123swk123/neoLED-frame-grabber/schematic/neoLED_framegrabber_bottom_layer_mirrored.pdf

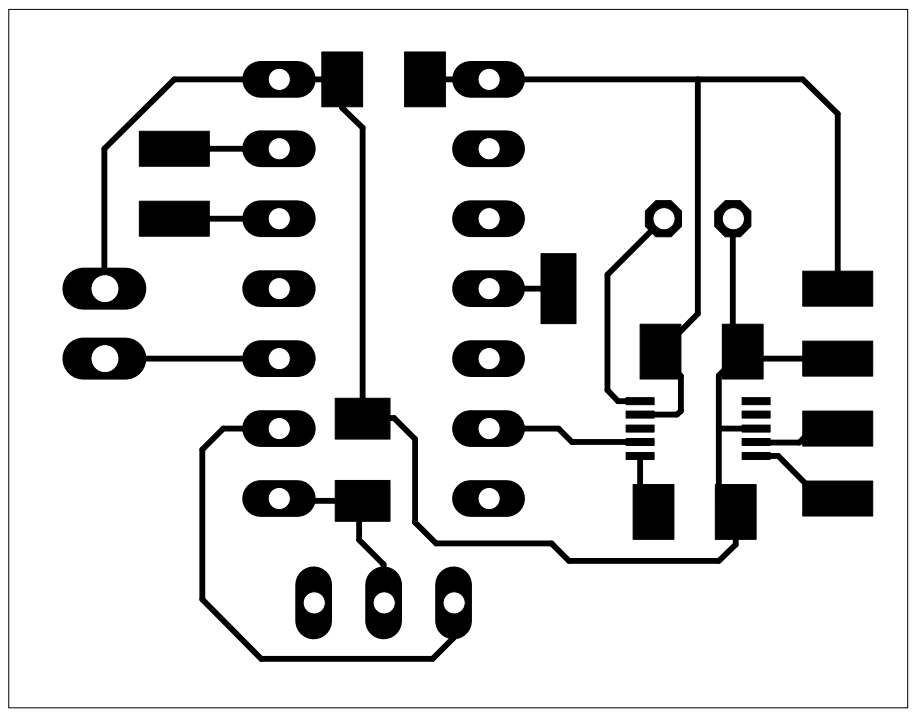
[picture p7: page 1]
