123swk123/neoLED-frame-grabber/schematic/neoLED_framegrabber_schematic.pdf

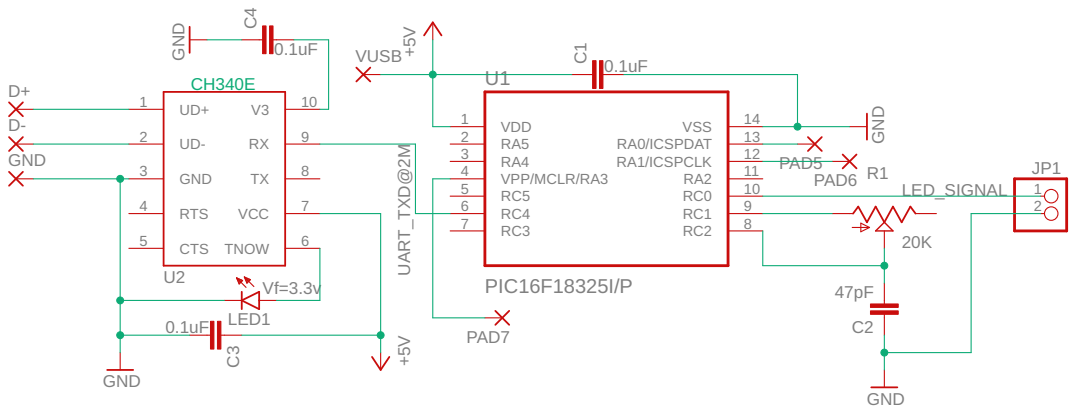
[picture p8: page 1]
