123swk123/neoLED-frame-grabber/schematic/neoLED2SPI.PDF

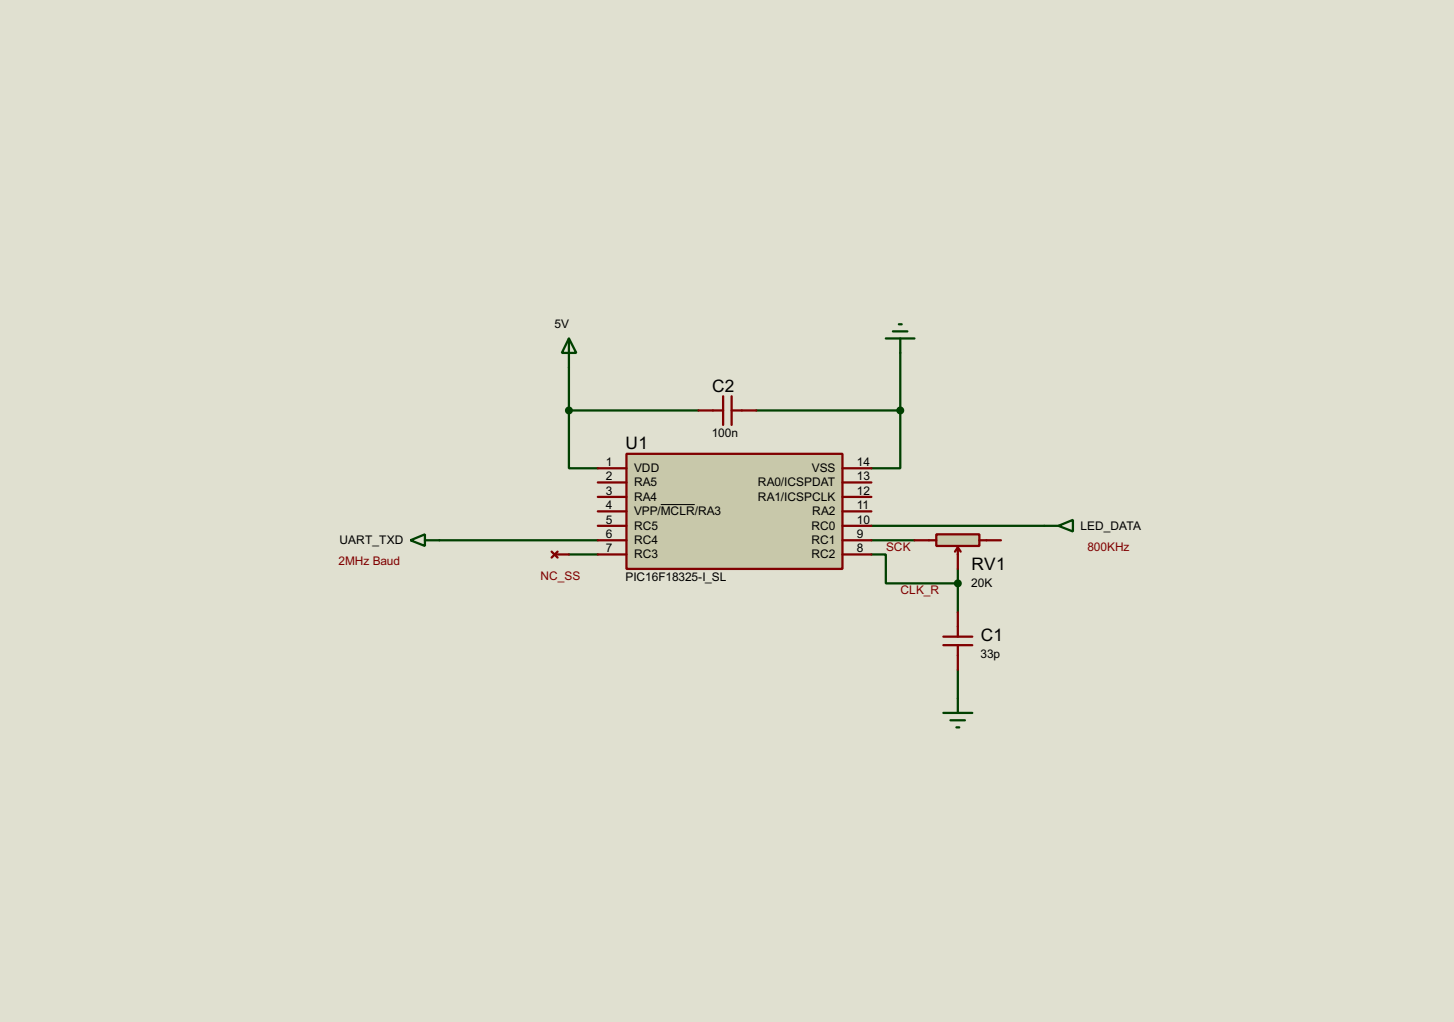
[picture p9: page 1]
