123swk123/neoLED-frame-grabber/(threads)

Thread 1 (2020-07-04):

which platform will require for setup

Kamal-Sonani, 2020-07-04:
i'm using Pycharm, never done with Qt.

check this [image](https://imgur.com/a/hNDin6l)
Where i stuck?
can you please tell me basic steps ?
i sorted all other steps in hardware

Thanks.

123swk123, 2020-07-05:
you need mention some required(must) parameters to run the viewer,
- led type
- led layout arrangement
- panel size (width and height)
- serial port to connect.

for example if you want to frame grab for a led panel(col x row) 16x32 made of ws2811 led and arranged as snake style left to right.

`main.py --led WS2811 --layout SnakeL2R --width 32 --height 16 --port com1`

I have tested it on win10, ubuntu 16.xx/18.xx/20.xx

Kamal-Sonani, 2020-07-11:
i tried & works fine ,UI is opened as per defined matrix size.

i'll check with hardware

Thanks @123swk123

123swk123, 2020-07-20:
cool! @Kamal-Sonani

Closed 2020-07-20.

Thread 2 (2020-10-10):

Not getting any view from input, only layout opened.

Kamal-Sonani, 2020-10-10:
I tried as your documentation , but not getting any animation on matrix.

Is their any other way to verify ?

123swk123, 2020-10-10:
Use --verbose command line option which will show you how the internal buffer is filled and managed, that will give you rough idea where to focus troubleshooting.

123swk123, 2020-10-10:
By the way can you post your command line options?

Kamal-Sonani, 2020-10-10:
https://www.youtube.com/watch?v=QBZyEKiyt6U

just check this video

123swk123, 2020-10-10:
Append --verbose to your command line options

neoLEDViewer.py --led WS2811 --layout SnakeL2R --width 10 --height 10 --port com6 --verbose

Just make sure led panel width and height mention the command line and you led controller's configured width and height matches.

As per your video I think hardware is working at least, try to view the terminal output in hex mode.

Kamal-Sonani, 2020-10-11:
neoLEDViewer.py --led WS2811 --layout SnakeL2R --width 10 --height 10 --port com6 **--verbose**

 --verbose showing some data, but no success

check it here https://youtu.be/Y6RfQIV-6Gs

123swk123, 2020-10-11:
Could you copy paste the log? It's difficult to read the log over the video.

Also did you tune the pot to match your led timing?

For ws2811 approximately you have to keep the pot @ middle position (10k)

123swk123, 2020-10-11:
In your led controller how many leds have you configured to drive? And what's your led panel size in number of rows and columns.

Kamal-Sonani, 2020-10-11:
@123swk123 yes, i placed 50k variable pot & set to 10k with 33pf cap.

Dump file remains 0kb (while running or closed GUI of python)

I'll verify & update with same.

123swk123, 2020-10-11:
As per your youtube log I see that python application is unable to find the EOS (0D 0A) sequence, this can happen only when clock recovery is having some trouble.

So could you tune the POT slowly until you see some activity on the python viewer.

Also set the led size to 2 or 4 through command line option, for rendering 2000 leds Qt QML takes huge CPU resource if LED size > 8

Kamal-Sonani, 2020-10-12:
Here is log file
[dump.zip](https://github.com/123swk123/neoLED-frame-grabber/files/5363448/dump.zip)

& For verbose check video
https://youtu.be/w-OPn9B3ZMA

Kamal-Sonani, 2020-10-12:
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

 suspect (i think ) >>my controller's dataline
blue dataline = 600 led
yellow dataline = 2000 led

led works well on both dataline
yellow line is without any reset pulse in between each 3 byte (RGB) & blue dataline have small delay pulse

after one complete frame (600 led & 2000 led )each dataline have little bit longer reset pulse

123swk123, 2020-10-12:
Let me go through the dump zip, by the way did you try to tune the pot while led controller running?

Kamal-Sonani, 2020-10-12:
Yes,

I tried with tune.

123swk123, 2020-10-12:
in the dump.bin does not have '0D 0A' sequence this means your hardware was not able to sense the reset led signal which is generated by LED controller. so the root cause of this problem is clock recovery mechanism.

using your DSO check the pin 9 and 8 of pic16f18325 for clock recovery, it should have approximately 50% to 60% duty cycle.

FYI: this hardware expects 5v LED signal and not 3.3v voltage level.

123swk123, 2020-10-13:
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

I just remembered due to python implementation it has limitation on FPS, currently at the max it supports 5~8fps for 2000LEDs and 20~25fps for about 600LEDs

for more higher speed we may have to do native implementation using C/C++.

123swk123, 2020-10-13:
capturing 2000 LEDs @ ledsize 5

`&$env:pythonpath .\neoLEDViewer.py --led WS2811 --layout ZigZagL2R --width 100 --height 20  --port COM10 --ledsize 5`

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
