123swk123/neoLED-frame-grabber/(commit log)

2019-11-04 fixed spurious refresh rate when discarding frames
2019-11-06 improved refresh speed and frame dropping
2020-10-11 updated schematic with CH340E usb2uartcnc files to make pcbfixed high cpu resource when EOS is received with a break
